8010yama/my-roomba-nav/README.md

# my-roomba-nav：自作の自律移動お掃除ロボット（ROS 2）



Raspberry Pi 5・Raspberry Pi Pico 2・2D LiDAR（LD19）で作った、家庭用お掃除ロボットのソフトウェア一式です。
地図を作り、置かれた場所から自分の位置を見つけ、指定した範囲をくまなく掃除して、終わったら定位置に戻ります。

機体（外装は Fusion で設計）、回路、足回りのマイコン、ROS 2 のノードまで一人で開発しています。

<p align="center">
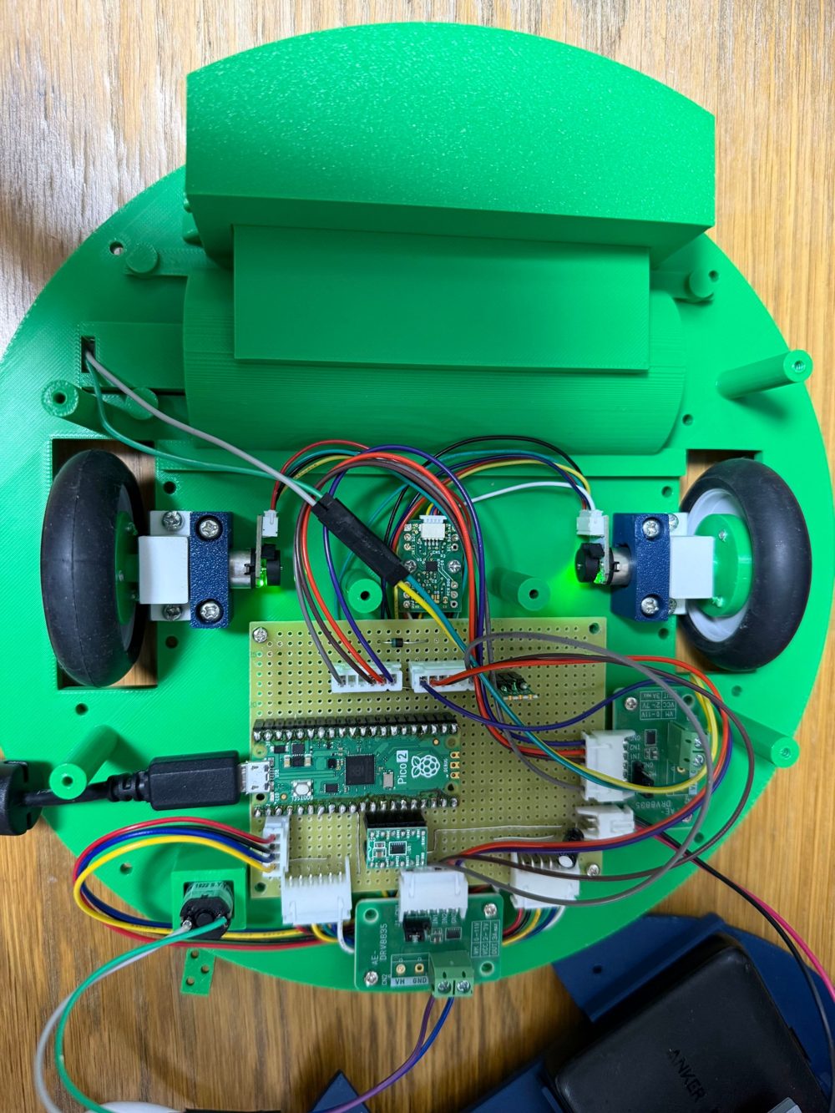
[picture p1: docs/images/robot_inside.jpg]
上ぶたを外した機体：Pico 2 を載せた自作の基板、ブラシ用モータドライバ 2 枚、左右の駆動輪とエンコーダ、メインブラシ
  
</p>
<p align="center"><sub>上ぶたを外した状態。中央が Pico 2 を載せた自作のユニバーサル基板、左右が駆動輪とエンコーダ、上がメインブラシ、左下がサイドブラシ。</sub></p>

<p align="center">
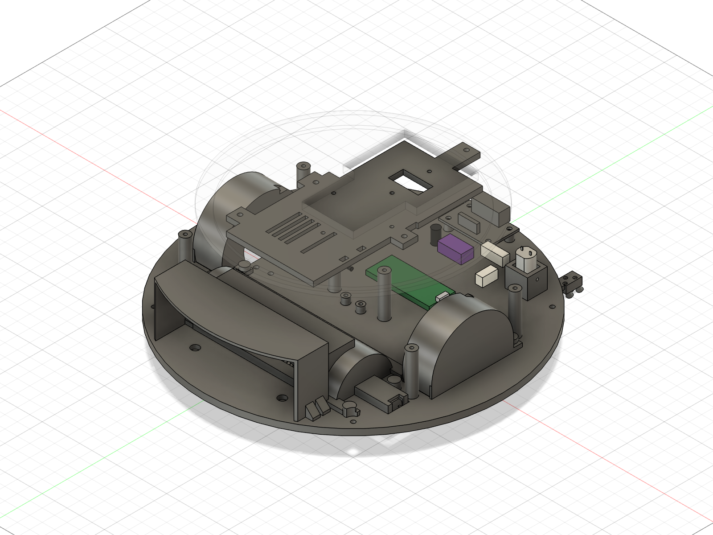
[picture p2: cad/roomba2.png]
Fusion で設計した機体の CAD モデル
  
</p>
<p align="center"><sub>Fusion で設計した機体。部品はすべて 3D プリントで作った（<a href="cad">cad/</a>）。</sub></p>

<!-- ここに走行中の地図・経路の GIF を入れる -->

## できること

- **地図づくり**：コントローラで部屋を一周すると、slam_toolbox で地図ができる
- **自己位置推定**：起動するとその場でゆっくり回り、地図全体から自分の位置を探す
- **くまなく掃除**：地図上で範囲をクリックすると、ジグザグの掃除経路を自分で作って走る。物があって進めないときは回り道を作って続ける
- **ワンタッチ掃除**：`/clean` を呼ぶと、自己位置推定 → 登録した範囲の掃除 → 定位置へ帰還、までを自動で行う
- **ウェイポイント走行**：クリックした点を順番に回る（回り続ける見回りも可）
- **手動操作**：Pro コントローラで走行とブラシ（メイン・サイド）を操作
- **可視化**：PC の Foxglove から、地図・スキャン・経路・掃除し終えた所を見ながら操作

## システム構成

```mermaid
flowchart LR
  subgraph PC["PC"]
    FG["Foxglove<br/>（表示・クリックで指示）"]
  end
  subgraph Pi["Raspberry Pi 5（ROS 2 Humble）"]
    LD["ldlidar_stl_ros2<br/>/scan"] --> SN["laser_tools<br/>/scan_fixed"]
    SN --> LOC["slam_toolbox / AMCL<br/>地図・自己位置"]
    PB["pico_bridge<br/>/odom・/imu/data"] --> EKF["robot_localization<br/>EKF"]
    EKF --> NAV["Nav2<br/>経路計画・追従"]
    LOC --> NAV
    TM["roomba_tasks<br/>掃除経路・自己位置推定・帰還"] --> NAV
    NAV -->|"/cmd_vel"| PB
    TM -->|"/brush"| PB
  end
  subgraph Pico["Raspberry Pi Pico 2（足回り）"]
    HW["モーター・エンコーダ<br/>IMU・ブラシ"]
  end
  PB <-->|"USB シリアル"| HW
  JOY["Pro コントローラ"] --> Pi
  FG <-->|"WebSocket"| Pi
```

## パッケージ構成

| パッケージ | 言語 | 中身 |
|---|---|---|
| [`pico_bridge`](src/pico_bridge) | C++ | Pico との USB シリアル通信。速度指令をタイヤに送り、エンコーダと IMU からオドメトリを出す。EKF の設定 |
| [`laser_tools`](src/laser_tools) | C++ | LD19 のスキャンを、SLAM が扱える形（いつも同じ点の数）に並べ直し、ノイズを消す |
| [`roomba_tasks`](src/roomba_tasks) | C++ | くまなく掃除の経路生成と実行、ウェイポイント走行、自己位置推定、定位置への帰還、ブラシ操作 |
| [`roomba_nav`](src/roomba_nav) | Python | ロボット一式・SLAM・地図走行の launch。Nav2 の標準設定をこのロボット用に書き換えて使う |
| [`ldlidar_stl_ros2`](https://github.com/ldrobotSensorTeam/ldlidar_stl_ros2) | C++ | LiDAR のドライバ（**外部**、サブモジュール） |

| フォルダ | 中身 |
|---|---|
| [`firmware/robot_pico`](firmware/robot_pico) | Pico 2 のファームウェア（C / Pico SDK）。タイヤの速度制御、エンコーダ、IMU、ブラシ |
| [`cad`](cad) | 機体の 3D データ。`print/` に 3D プリント用の部品ごとの STL、`roomba2_assembly.stl` に組み立て後の全体 |

`ldlidar_stl_ros2` 以外はすべて自作です。

## 工夫したところ

### くまなく掃除する経路を自分で作る（`roomba_tasks/coverage.hpp`）

Nav2 には「範囲をくまなく走る」機能がないので、地図（占有格子）から往復のジグザグ経路（ボストロフェドン）を作る部分を自作しました。

1. 距離変換（Felzenszwalb & Huttenlocher）で各マスから壁までの距離を求め、ロボットの中心が通ってよいマスを決める
2. ロボットからつながっているマスだけを残す（壁の向こうの部屋などを除く）
3. 平行なレーンを引き、障害物で分かれた「区画」ごとにジグザグで走る
4. 次に走る区画は、ダイクストラ法で**壁を回り込んだ実際の道のり**が一番近いものを選ぶ
5. レーンの向きは、区画とレーンの数が一番少なくなる向きを自動で選ぶ

レーンの間隔は 10 cm で、メインブラシの幅（11.4 cm）より少し狭くして塗り残しを防いでいます。

**途中で進めなくなったとき**：作った経路は Nav2 の controller_server（Regulated Pure Pursuit）にそのまま渡して走らせます。物が置いてあるなどで進めなくなったら、経路の少し先（0.4 m × 失敗回数）の点まで Nav2 の planner で回り道を作り、続きから再開します。ちゃんと進めたら失敗回数を戻し、5 回続けて失敗したらあきらめます。

### 置いた場所が分からなくても動き出せる（`roomba_tasks/localize.cpp`）

AMCL の位置の候補を地図全体にばらまき、その場でゆっくり回りながら AMCL に計算させ続けます。位置のばらつきが 25 cm、向きのばらつきが約 20° 以下になったら止まります。どこに置いても、自分の位置を見つけてから掃除を始められます。

### LiDAR のスキャンを SLAM に通す（`laser_tools`）

LD19 は 1 周ごとに点の数が変わるため、そのままでは slam_toolbox が受け付けません。角度を 500 個のマスに並べ直すノードを挟み、あわせて、ロボット自身の体（支柱・配線）が映った近すぎる点と、ぽつんと 1 点だけのノイズを消しています。

### オドメトリと IMU を合わせる（`pico_bridge`）

タイヤのエンコーダから計算した位置と IMU の角速度を、robot_localization の EKF で合わせています。接続した直後の 2 秒で、ジャイロのずれを測って補正します。

### 止まるべきときに確実に止まる

- 速度指令（`/cmd_vel`）が 0.5 秒来なければ、ブリッジが停止を送る
- ブリッジやケーブルが止まっても、Pico 自身が 0.5 秒で止まる
- ブラシの指令が 1 秒途切れたらブラシを止める
- 速度には上限（0.3 m/s、2.0 rad/s）をかける

### 足回りのファームウェアを C で書き直す（`firmware/robot_pico`）

最初は MicroPython で書いていましたが、タイヤを速く回すとエンコーダのカウントを取りこぼすため、C（Pico SDK）で書き直しました。

- エンコーダは 2 相の両エッジを GPIO 割り込みで数える 4 逓倍
- タイヤの速さは 50 Hz のループで、フィードフォワード ＋ PI 制御
- PWM は 20 kHz（モータの音が耳に聞こえない周波数）
- 1 秒以上プログラムが止まったら、ウォッチドッグで再起動してモータも止める

> **注**：今リポジトリにある `main.c` は、ブラシの命令（`B`）と IMU の自動復帰を足す前の版です。実機で動いている最新版に、あとで差し替えます。

ラズパイとの通信は 1 行 1 命令のテキスト（`W 1500 1500` で左右のタイヤを 1500 カウント/秒など）にしていて、付属の `pico_term.py` から手で打って動きを確かめられます。

### ROS に依存しない部分を切り出してテストする

経路生成（`coverage.hpp`）、スキャンの並べ直し（`resample.hpp`）、差動二輪の計算（`diffdrive.hpp`）はヘッダーに切り出し、ROS なしで単体テストできるようにしています。

## ハードウェア

| 部品 | 型番など | 役割 |
|---|---|---|
| メインのコンピュータ | Raspberry Pi 5 | ROS 2 Humble（コンテナ上）、SLAM・Nav2 |
| マイコン | Raspberry Pi Pico 2 | タイヤ・ブラシ・エンコーダ・IMU の制御 |
| LiDAR | LDROBOT LD19 | 周囲 360° の距離 |
| IMU | LSM6DSV16X | 角速度・加速度（I2C） |
| タイヤ用モータドライバ | DRV8835 | 左右の駆動輪（基板の上） |
| ブラシ用モータドライバ | AE-DRV8835-P ×2 | メインブラシ・サイドブラシ |
| 昇圧 | XC9306 | 電池から Pico 用の 5V を作る |
| 駆動 | エンコーダ付き DC モータ ×2 | 差動二輪 |
| 操作 | Pro コントローラ | 手動操作・ブラシ |
| 機体 | 直径 30 cm、3D プリント | Fusion で設計 |

### 回路

基板はユニバーサル基板に手配線で作っています。

```mermaid
flowchart LR
  BAT["電池"] --> XC["XC9306<br/>5V 昇圧"] --> D1["D1<br/>逆流防止"] --> PICO["Pico 2<br/>VSYS"]
  BAT --> DRVW["DRV8835<br/>タイヤ用"]
  BAT --> DRVB["AE-DRV8835-P ×2<br/>ブラシ用"]
  PICO -->|"PWM ×4"| DRVW --> MW["左右のモータ"]
  MW -->|"エンコーダ A/B ×2"| PICO
  PICO -->|"PWM・向き"| DRVB --> MB["メイン・サイドブラシ"]
  IMU["LSM6DSV16X"] <-->|"I2C"| PICO
  PICO <-->|"USB シリアル"| PI["Raspberry Pi 5"]
  LIDAR["LD19"] -->|"USB シリアル"| PI
```

D1 は、Pico がラズパイの USB からも給電されるため、USB の 5V が電池側へ流れ込まないように入れています。

**Pico 2 のピン割り当て**

| GP | つなぎ先 | 内容 |
|---|---|---|
| 2 | IMU SDA | I2C1（アドレス 0x6B） |
| 3 | IMU SCL | I2C1 |
| 4 | 左エンコーダ C2 | |
| 5 | 左エンコーダ C1 | 左は前進でプラスになるよう向きを反転 |
| 10 | DRV8835 AIN1 | 左モータ 前進側（PWM） |
| 11 | DRV8835 AIN2 | 左モータ 後退側（PWM） |
| 12 | DRV8835 BIN1 | 右モータ 後退側（PWM） |
| 13 | DRV8835 BIN2 | 右モータ 前進側（PWM） |
| 17 | サイドブラシ用ドライバ IN1（PHASE） | サイドブラシの向き |
| 18 | サイドブラシ用ドライバ IN2（ENABLE） | サイドブラシの速さ（PWM） |
| 19 | メインブラシ用ドライバ IN2（ENABLE） | メインブラシの速さ（PWM） |
| 20 | 右エンコーダ C1 | |
| 21 | 右エンコーダ C2 | |
| 22 | メインブラシ用ドライバ IN1（PHASE） | メインブラシの向き（毛が絡んだら逆回転） |

タイヤ用は IN/IN モード、ブラシ用は PHASE/ENABLE モードで使っています。

## 動かし方

```bash
mkdir -p ~/roomba_ws && cd ~/roomba_ws
git clone --recursive https://github.com/8010yama/my-roomba-nav.git .
colcon build
source install/setup.bash

ros2 launch roomba_nav robot.launch.py      # ロボットだけ（手動操作・LiDAR・Foxglove）
ros2 launch roomba_nav nav_slam.launch.py   # 地図を作りながら走る
ros2 launch roomba_nav nav_map.launch.py    # 保存した地図の上で走る（起動時に自己位置推定）
```

詳しい手順（必要なパッケージ、地図の保存、掃除範囲の登録、サービス一覧）は各パッケージの README を見てください。

- [roomba_nav](src/roomba_nav/README.md)：起動・SLAM・地図走行・掃除の操作
- [roomba_tasks](src/roomba_tasks/README.md)：掃除経路の作り方
- [pico_bridge](src/pico_bridge/README.md)：足回りとの通信・寸法の設定・安全の仕組み

## テスト

```bash
colcon test --packages-select laser_tools pico_bridge roomba_tasks
colcon test-result --verbose
```

## CI

push と Pull Request のたびに、GitHub Actions（[`.github/workflows/ci.yml`](.github/workflows/ci.yml)）で次の 3 つを自動で走らせています。

| ジョブ | 中身 |
|---|---|
| 単体テスト | ROS に依存しない部分（経路生成・スキャンの並べ直し・差動二輪の計算）のテスト。警告をエラー扱いにし、AddressSanitizer と UndefinedBehaviorSanitizer でメモリの不正アクセスや未定義動作も検出する |
| ROS 2 Humble | 実機と同じ ROS 2 Humble のコンテナで、全パッケージを colcon でビルドし、gtest を走らせる |
| ファームウェア | Pico SDK で Pico 2 のファームウェアをビルドし、`.uf2` を成果物として残す |

`v` から始まるタグ（例：`v1.0.0`）を push すると、3 つとも通ったときだけ、ファームウェアの `.uf2` を Release に添付して配布します。

## ライセンス

[MIT](LICENSE)。ただし、外部のものはそれぞれのライセンスに従います。

- `src/ldlidar_stl_ros2`：LDROBOT のドライバ（サブモジュール）
- `firmware/robot_pico/pico_sdk_import.cmake`：Raspberry Pi の Pico SDK に含まれるファイル（BSD-3-Clause）
