8010yama/my-roomba-nav/cad/print/main_brush_drive_hub.stl

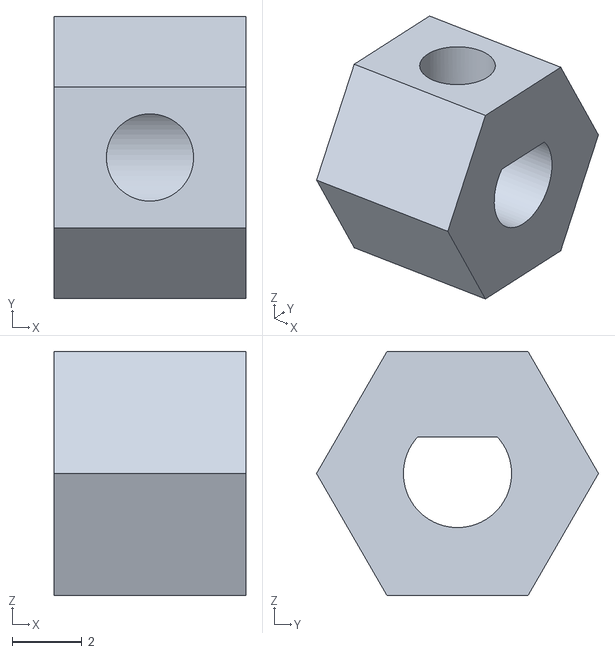
[picture p3: CAD file, 2026-11-04]
cad/print/main_brush_drive_hub.stl
5.50 x 8.08 x 7.00
