8010yama/my-roomba-nav/cad/roomba2_assembly.stl

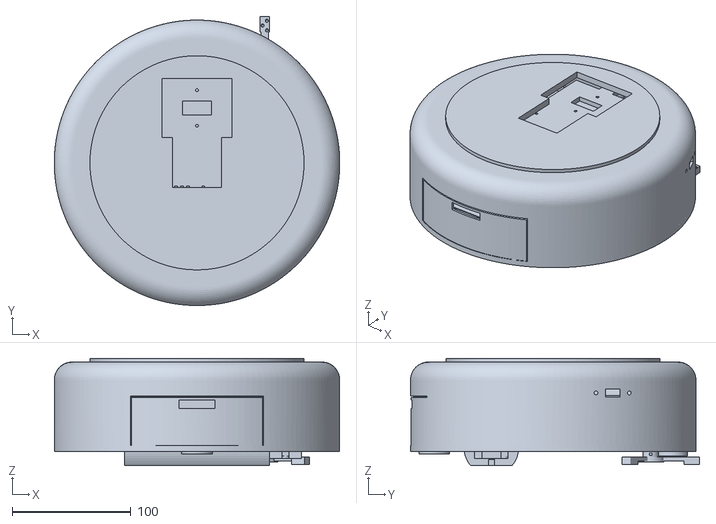
[picture p4: CAD file, 2026-11-04]
cad/roomba2_assembly.stl
240.0 x 243.0 x 90.0
