8010yama/my-roomba-nav/cad/print/main_brush_retainers_idler_keeper.stl

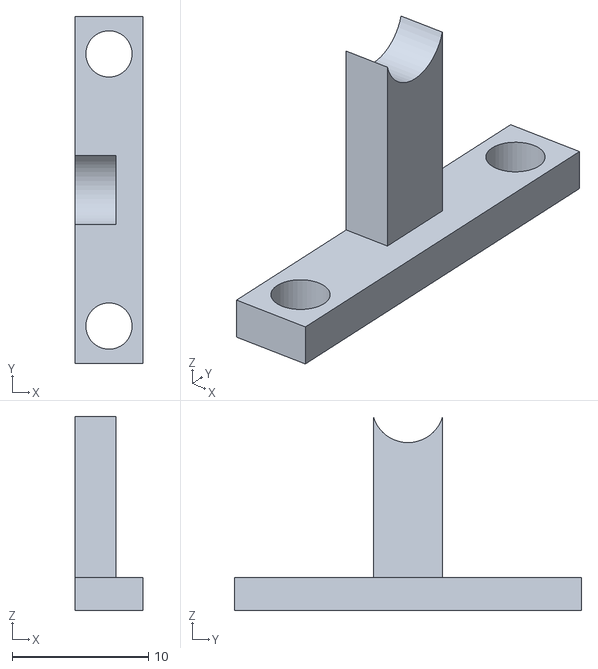
[picture p5: CAD file, 2026-11-04]
cad/print/main_brush_retainers_idler_keeper.stl
5.00 x 25.5 x 14.3
