8010yama/my-roomba-nav/cad/print/main_brush_frame.stl

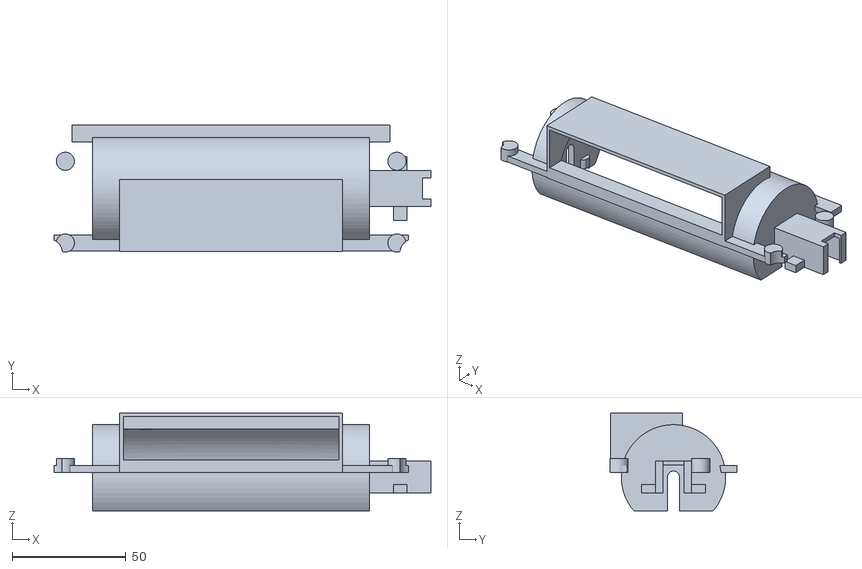
[picture p6: CAD file, 2026-11-04]
cad/print/main_brush_frame.stl
166.0 x 56.0 x 43.1
