8010yama/my-roomba-nav/cad/print/main_brush_retainers_motor_cover.stl

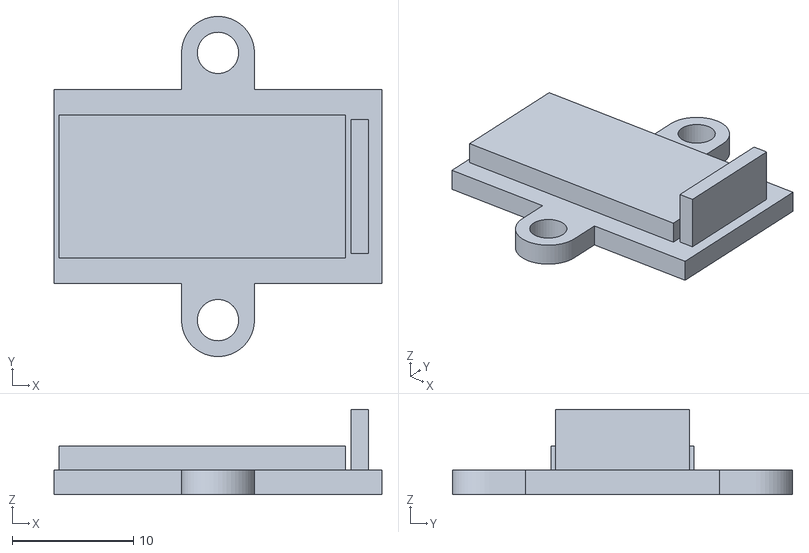
[picture p7: CAD file, 2026-11-04]
cad/print/main_brush_retainers_motor_cover.stl
27.0 x 28.0 x 7.00
