8010yama/my-roomba-nav/cad/print/main_brush_core.stl

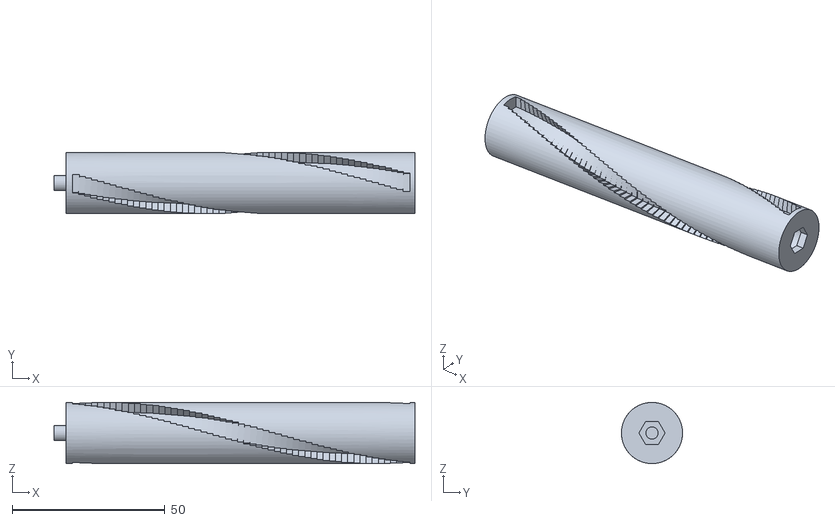
[picture p8: CAD file, 2026-11-04]
cad/print/main_brush_core.stl
118.0 x 20.0 x 20.0
