8010yama/my-roomba-nav/cad/print/upper_deck.stl

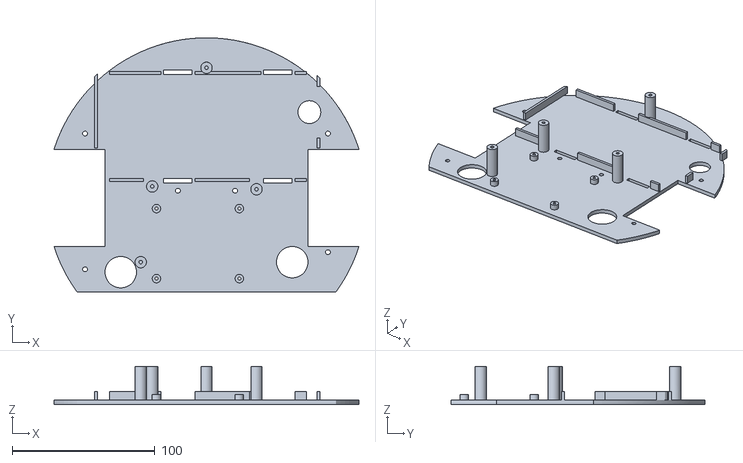
[picture p9: CAD file, 2026-11-04]
cad/print/upper_deck.stl
213.4 x 178.0 x 26.6
