8010yama/my-roomba-nav/cad/print/motor_cradle_L.stl

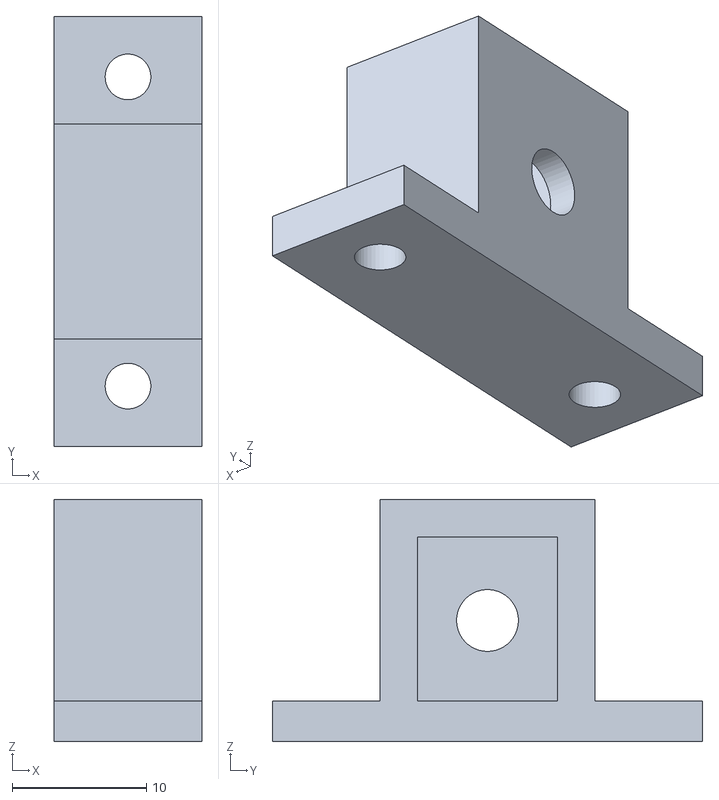
[picture p10: CAD file, 2026-11-04]
cad/print/motor_cradle_L.stl
11.0 x 32.0 x 18.0
