8010yama/my-roomba-nav/cad/print/motor_clamp_upper_L.stl

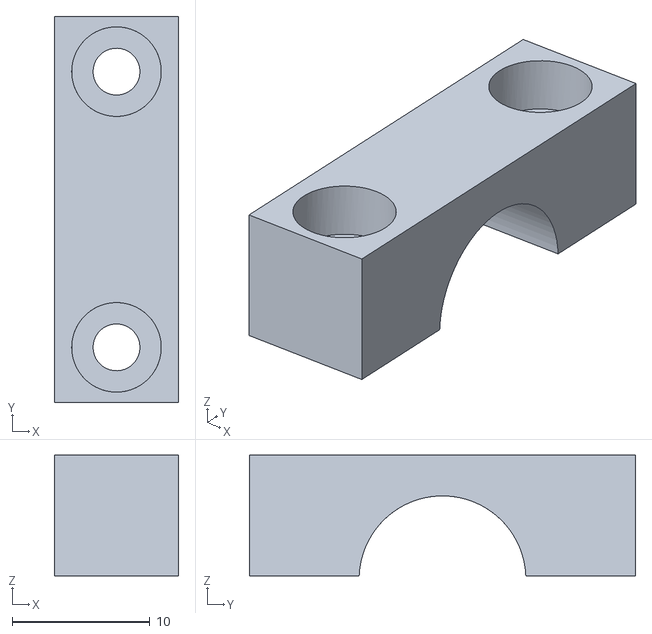
[picture p11: CAD file, 2026-11-04]
cad/print/motor_clamp_upper_L.stl
9.00 x 28.0 x 8.75
