8010yama/my-roomba-nav/cad/print/caster_spacer_front_4mm.stl

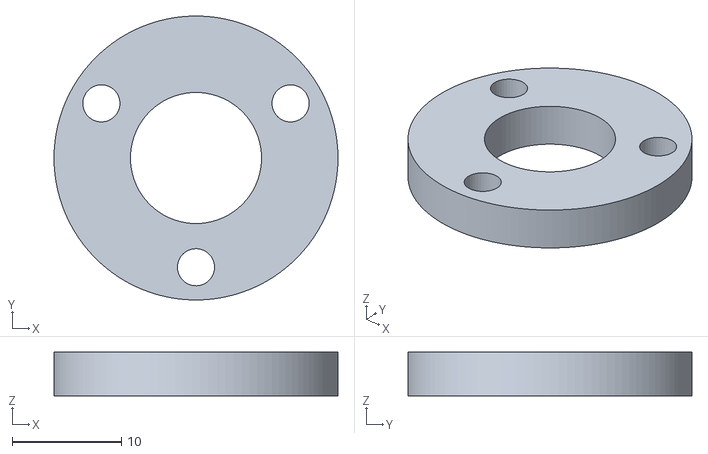
[picture p12: CAD file, 2026-11-04]
cad/print/caster_spacer_front_4mm.stl
26.0 x 26.0 x 4.00
