8010yama/my-roomba-nav/cad/print/wheel_fender_R.stl

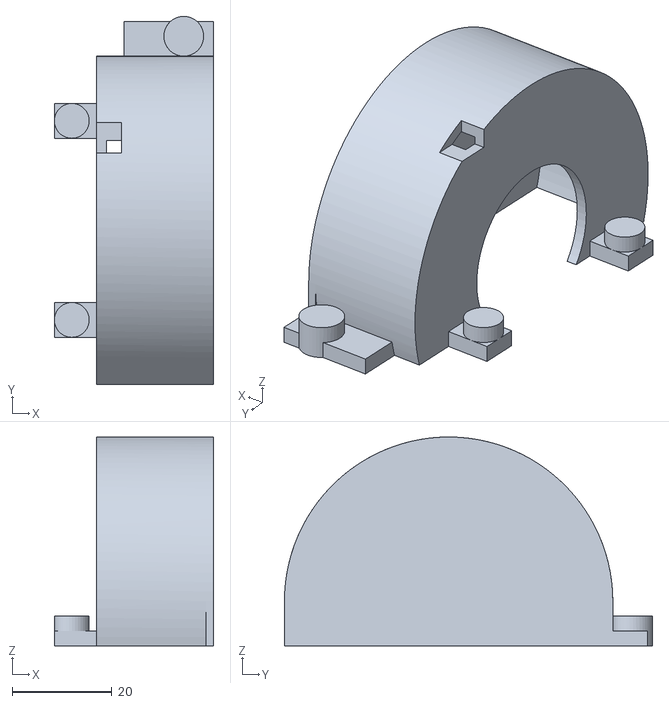
[picture p13: CAD file, 2026-11-04]
cad/print/wheel_fender_R.stl
32.0 x 74.0 x 42.0
