8010yama/my-roomba-nav/cad/print/side_brush_core.stl

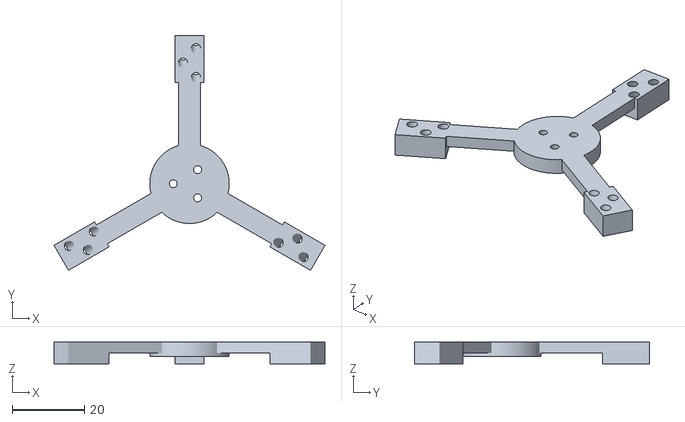
[picture p14: CAD file, 2026-11-04]
cad/print/side_brush_core.stl
75.0 x 65.0 x 6.00
