8010yama/my-roomba-nav/cad/print/wheel_adapter_R.stl

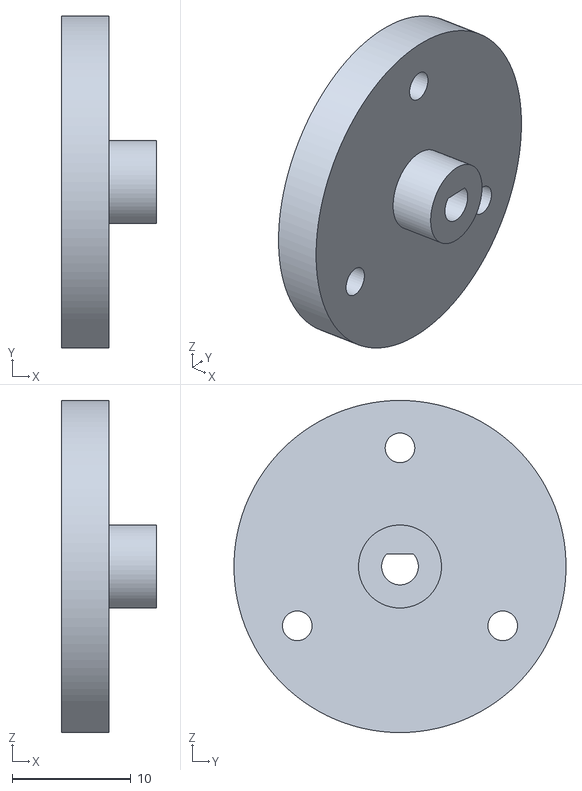
[picture p15: CAD file, 2026-11-04]
cad/print/wheel_adapter_R.stl
8.00 x 28.0 x 28.0
