8010yama/my-roomba-nav/cad/print/lidar_battery_platform.stl

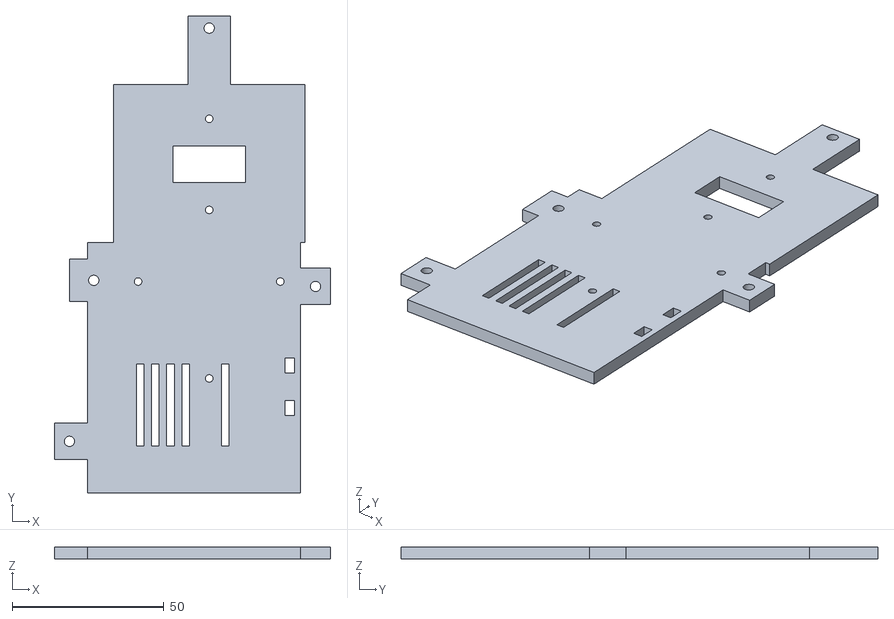
[picture p16: CAD file, 2026-11-04]
cad/print/lidar_battery_platform.stl
91.0 x 157.0 x 4.00
