8010yama/my-roomba-nav/cad/print/shell.stl

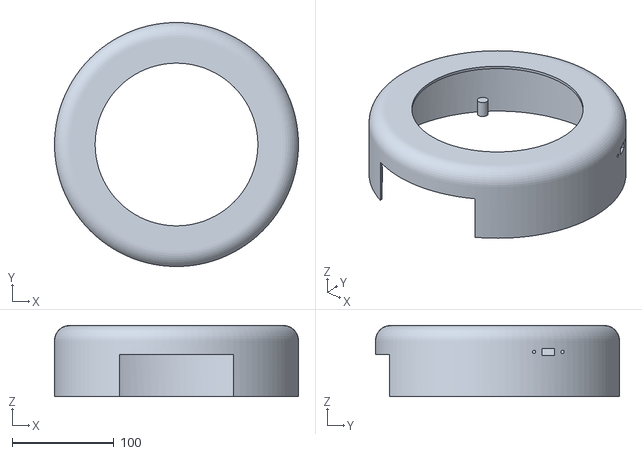
[picture p17: CAD file, 2026-11-04]
cad/print/shell.stl
240.0 x 240.0 x 70.0
