8010yama/my-roomba-nav/cad/print/caster_spacer_rear_2_5mm.stl

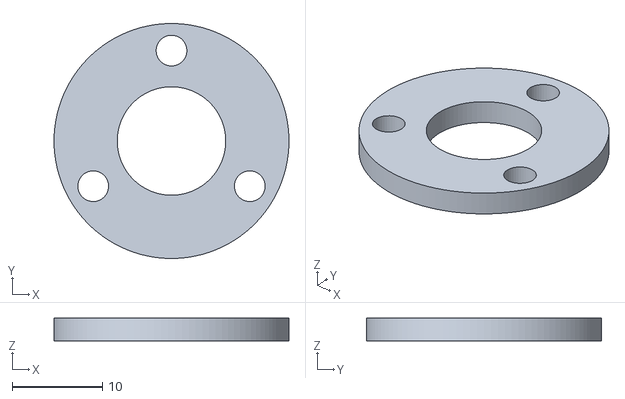
[picture p18: CAD file, 2026-11-04]
cad/print/caster_spacer_rear_2_5mm.stl
26.0 x 26.0 x 2.50
