8010yama/my-roomba-nav/cad/print/base_plate.stl

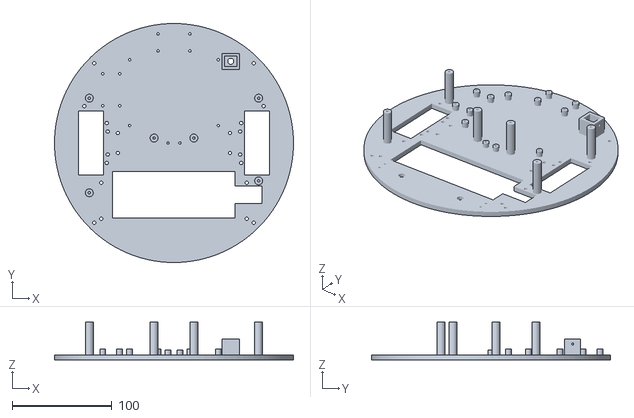
[picture p19: CAD file, 2026-11-04]
cad/print/base_plate.stl
239.9 x 240.0 x 38.0
