8010yama/my-roomba-nav/cad/print/side_brush_hub.stl

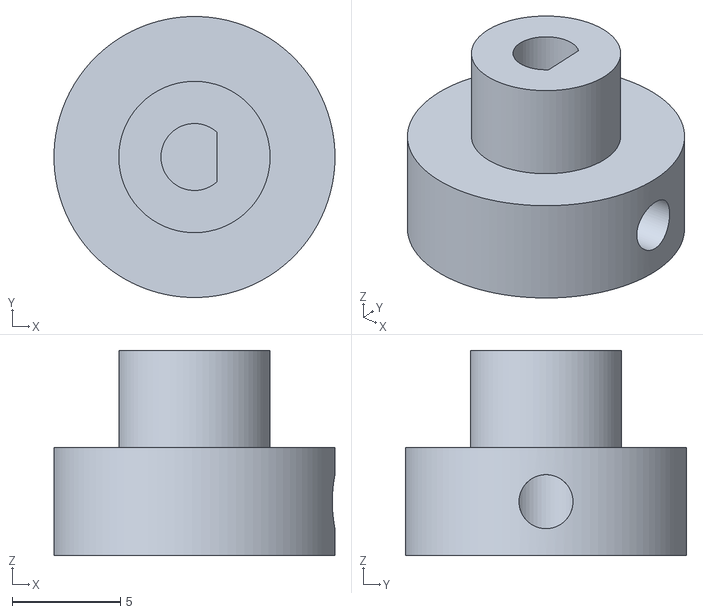
[picture p20: CAD file, 2026-11-04]
cad/print/side_brush_hub.stl
13.0 x 13.0 x 9.50
