8010yama/my-roomba-nav/cad/print/lid.stl

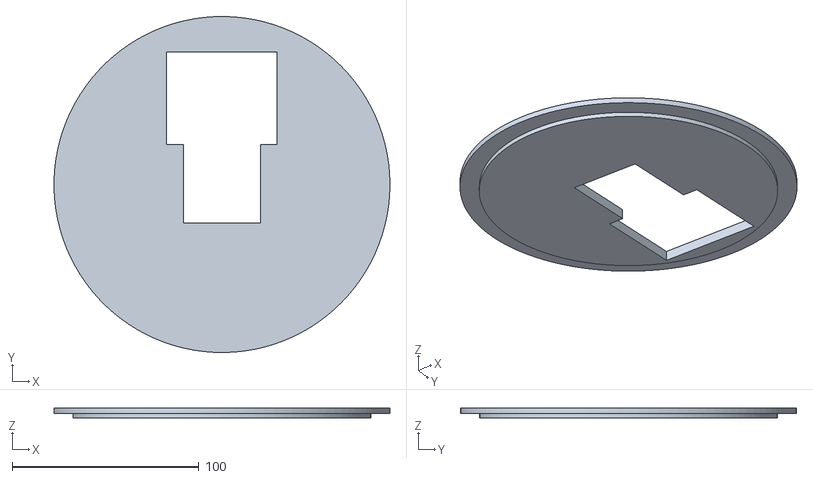
[picture p21: CAD file, 2026-11-04]
cad/print/lid.stl
180.0 x 180.0 x 5.50
