8010yama/my-roomba-nav/cad/print/dust_bin.stl

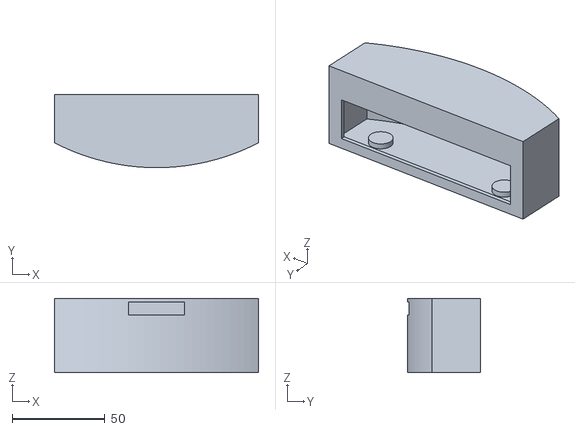
[picture p22: CAD file, 2026-11-04]
cad/print/dust_bin.stl
110.0 x 39.5 x 40.0
