8010yama/my-roomba-nav/cad/print/dust_bin_sleeve.stl

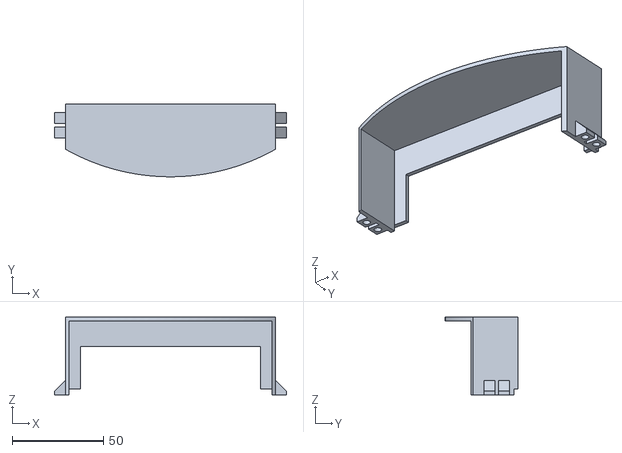
[picture p23: CAD file, 2026-11-04]
cad/print/dust_bin_sleeve.stl
127.2 x 39.8 x 42.6
