8010yama/my-roomba-nav/(list of files, cad)

Other CAD files:
cad/print/motor_clamp_upper_R.stl
cad/print/motor_cradle_R.stl
cad/print/motor_clamp_lower_R.stl
cad/print/wheel_fender_L.stl
cad/print/motor_clamp_lower_L.stl
cad/print/wheel_adapter_L.stl
