8010yama/my-roomba-nav/(commit log)

2026-11-04 Add Pico 2 firmware (C, Pico SDK)
2026-11-04 Add roomba2 STL and overview image
    [roomba2.stl]
2026-11-04 Remove wiring from roomba2 STL and image
    [roomba2.stl]
2026-11-04 Split roomba2 into per-part STLs, add assembly STL
    [base_plate.stl, caster_spacer_front_4mm.stl, caster_spacer_rear_2_5mm.stl, dust_bin.stl, dust_bin_sleeve.stl, lid.stl, lidar_battery_platform.stl, main_brush_core.stl]
2026-11-04 Document firmware, CAD, hardware and wiring in README
2026-11-04 Fix CI: install ARM C++ library, ignore firmware in colcon
